emm1912/RadioController-with-an-AVR---Xbee/Images/Bottom.png

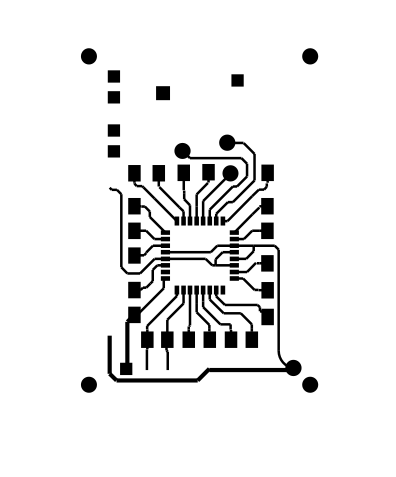
Images/Bottom.png
