emm1912/RadioController-with-an-AVR---Xbee/Images/Top.png

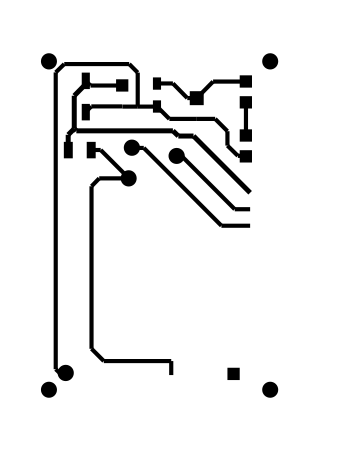
Images/Top.png
