emm1912/RadioController-with-an-AVR---Xbee/(list of files, drawings)

Other design files:
RCAuto Altium/RCAuto.PcbDoc
RCAuto Altium/RCAuto.PrjPCB
RCAuto Altium/RCAuto.SchDoc
